HackerspaceWroclaw/Warsztaty_Fuzz/Fuzz_Lid.dxf

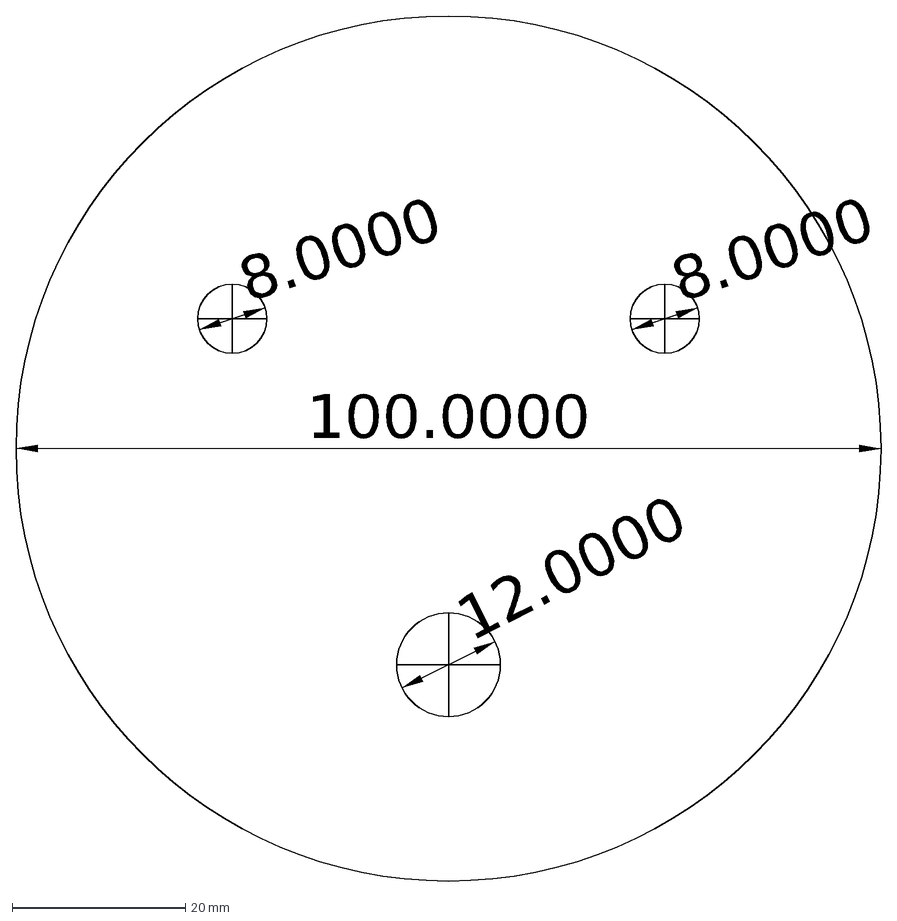
[picture p5: CAD file, 2019-07-26]
Fuzz_Lid.dxf
12.0000
100.0000
8.0000
