HackerspaceWroclaw/Warsztaty_Fuzz/dist/Fuzz_bottom.pdf

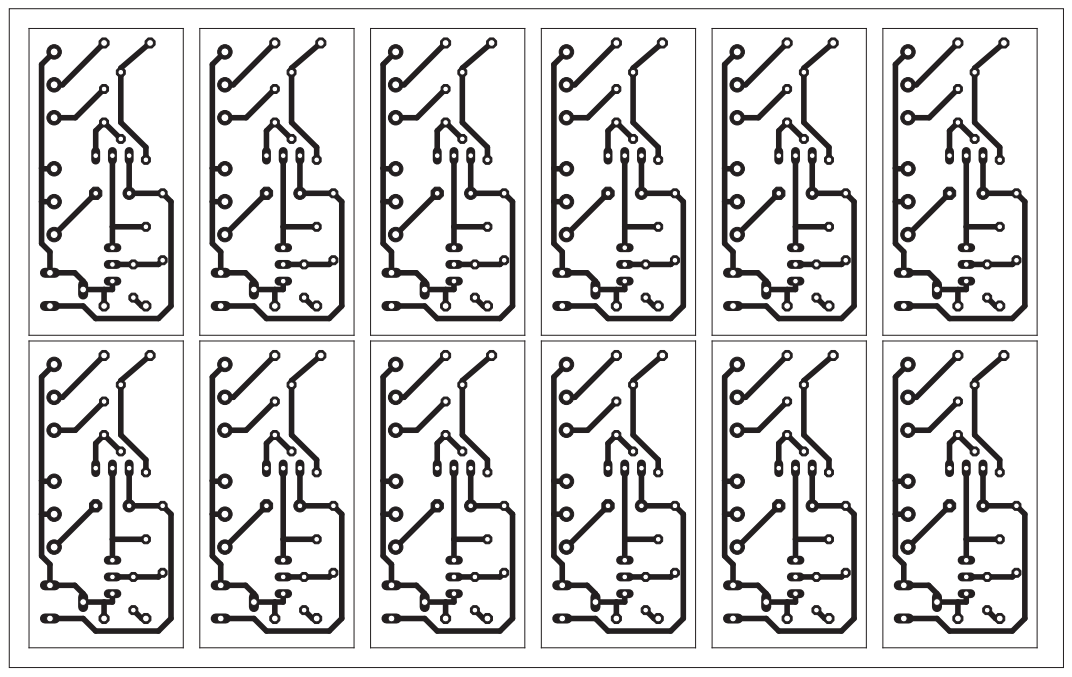
[picture p6: page 1]
