HackerspaceWroclaw/Warsztaty_Fuzz/dist/Fuzz_Lid.pdf

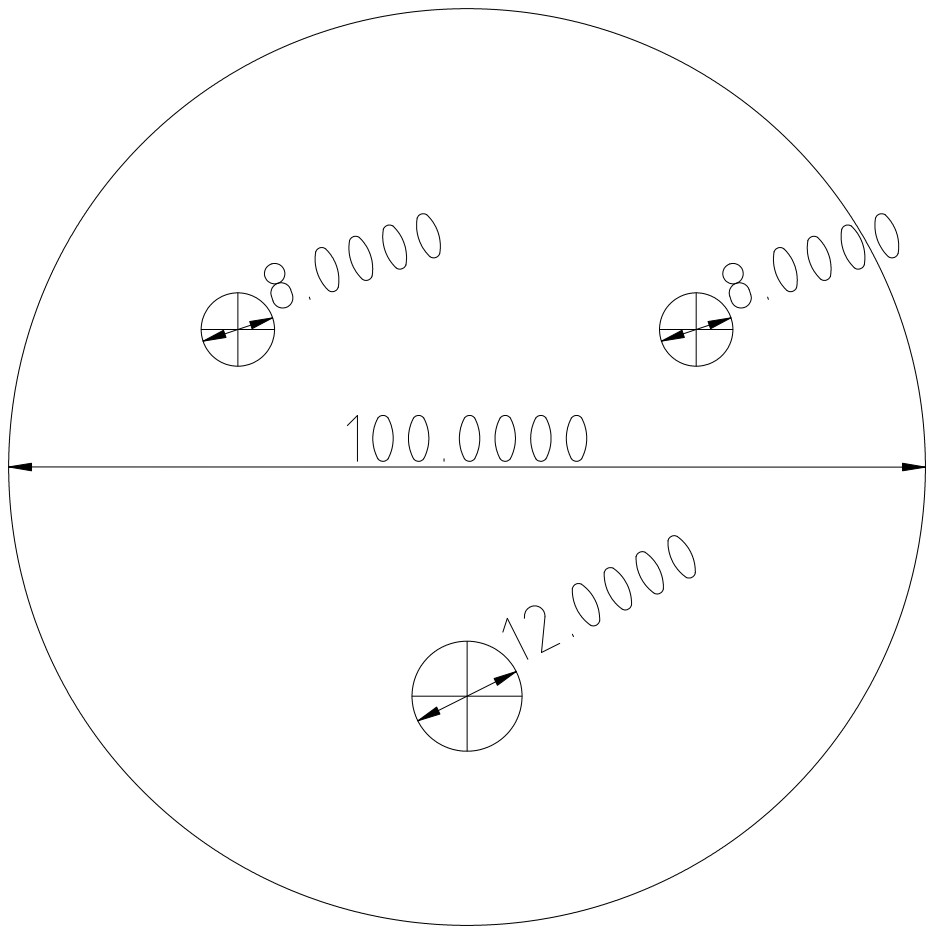
[picture p7: page 1]
