HackerspaceWroclaw/Warsztaty_Fuzz/dist/Fuzz_topSilk.pdf

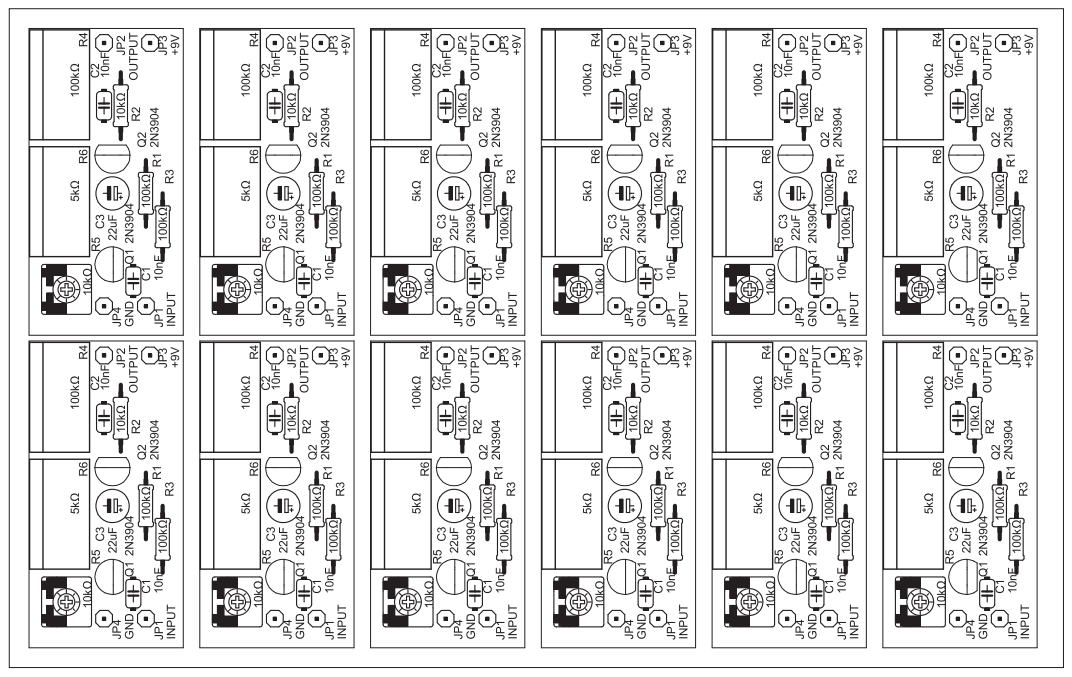
[picture p8: page 1]
