HackerspaceWroclaw/Warsztaty_Fuzz/Fuzz.brd

## EAGLE design Fuzz.brd (2019-07-26)

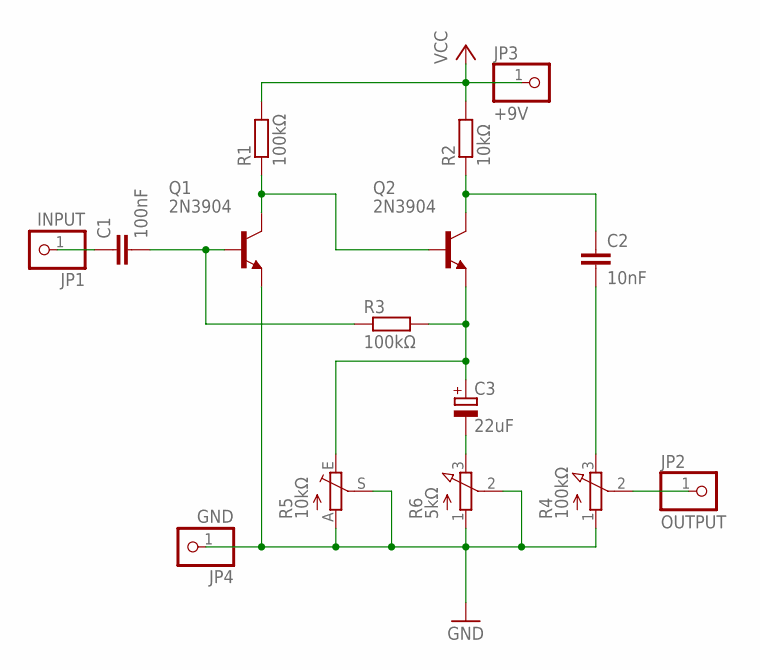
[picture p9: schematic Fuzz.sch]

Parts:
C1: 100nF; C050-024X044
C2: 10nF; C050-024X044
C3: 22uF; E5-5
JP1: INPUT; 1X01
JP2: OUTPUT; 1X01
JP3: +9V; 1X01
JP4: GND; 1X01
Q1, Q2: 2N3904; TO92-EBC
R1, R3: 100kΩ; 0207/10
R2: 10kΩ; 0207/10
R4: 100kΩ; 3RP/1610N
R5: 10kΩ; CA6V
R6: 5kΩ; 3RP/1610N

Connections:
GND: JP4.1, Q1.E, R4.1 (A), R5.A, R5.S, R6.1 (A), R6.2 (S)
INPUT: C1.1, JP1.1
unnamed: C1.2, Q1.B, R3.1
unnamed: Q1.C, Q2.B, R1.1
unnamed: C2.1, Q2.C, R2.1
unnamed: C2.2, R4.3 (E)
unnamed: C3.+, Q2.E, R3.2, R5.E
unnamed: C3.-, R6.3 (E)
OUTPUT: JP2.1, R4.2 (S)
VCC: JP3.1, R1.2, R2.2

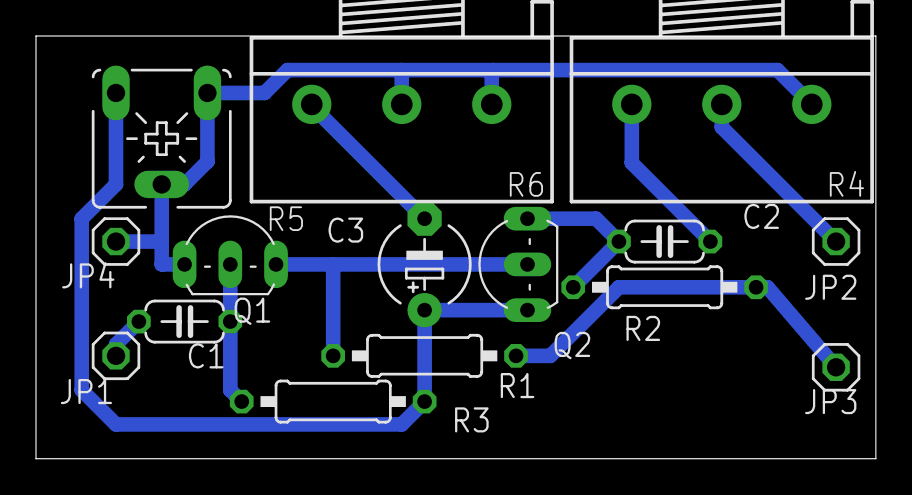
[picture p10: board Fuzz.brd from above]

Board: 2 copper layers, 46.7 x 23.5 mm, 15 parts (0 on the bottom side), 10 nets.
