HackerspaceWroclaw/Warsztaty_Fuzz/dist/Fuzz_wiring.png

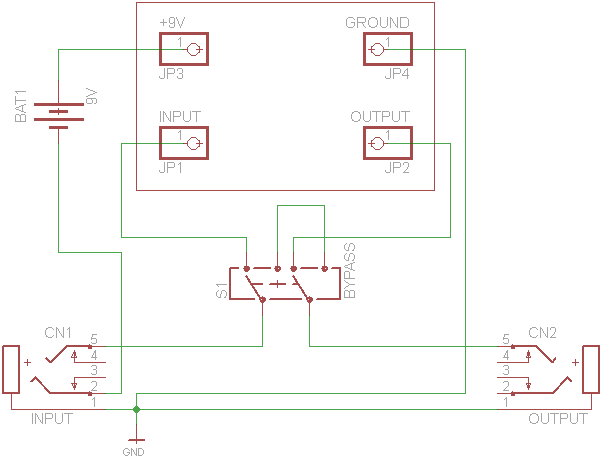
dist/Fuzz_wiring.png
